philetus/bottery_piccolo/README.md

bottery_piccolo
===============

emerald bottery's fork of diatom's piccolo tiny cnc
