philetus/bottery_piccolo/telaio/telaio_v7_Instructions.pdf

## Telaio v7 Assembly Diagrams

## Z - Stage

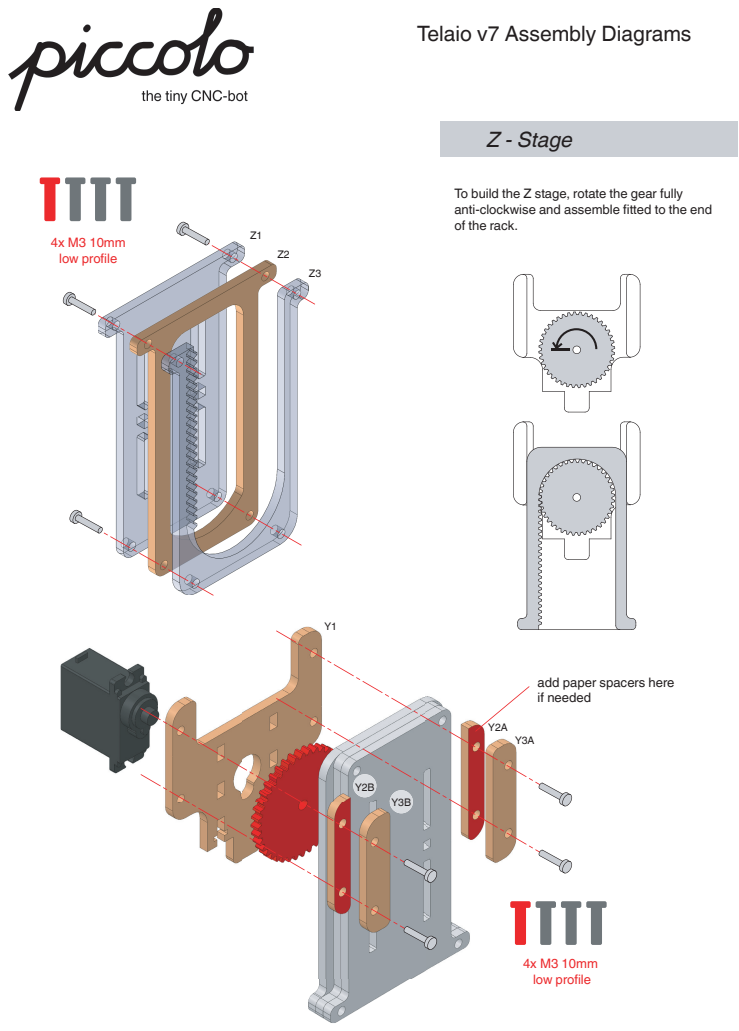
[picture p1: page 1]
4x M3 10mm low profile

To build the Z stage, rotate the gear fully
anti-clockwise and assemble fitted to the end
of the rack.

add paper spacers here
if needed

## X & Y - Stages

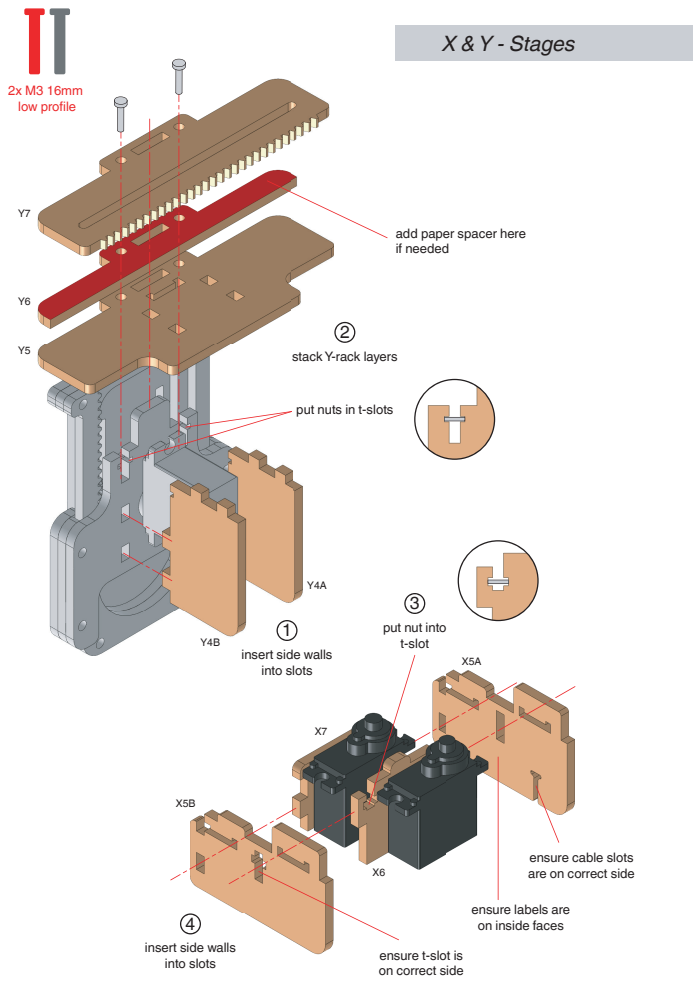
[picture p2: page 2]
2x M3 16mm low profile; put nut into; t-slot

add paper spacer here
if needed

stack Y-rack layers

put nuts in t-slots

insert side walls
into slots

ensure cable slots
are on correct side

ensure labels are
on inside faces

ensure t-slot is
on correct side

3

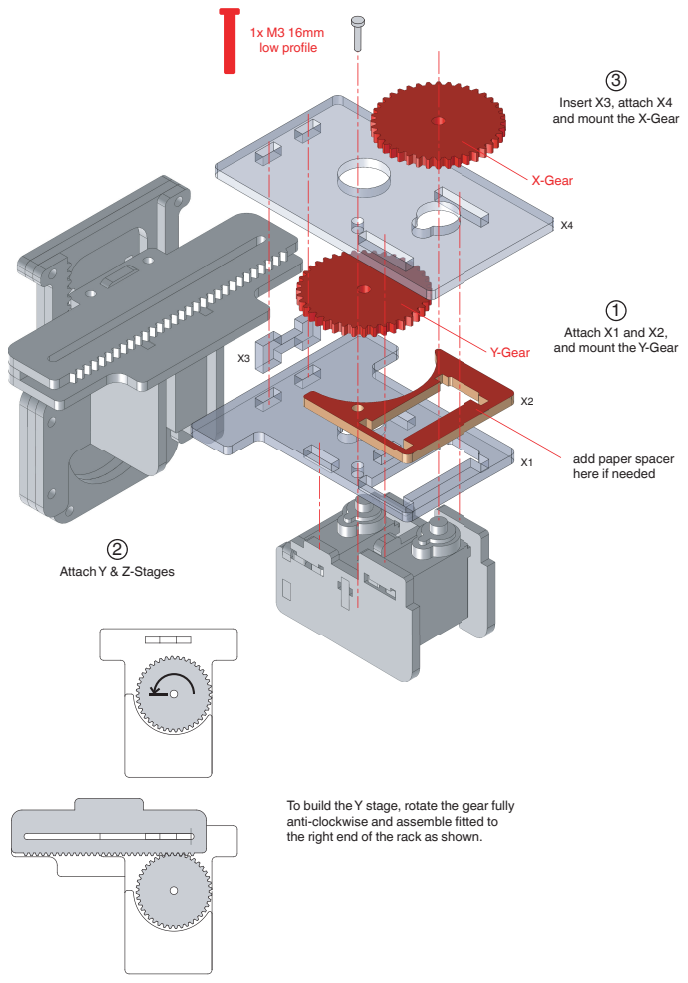
[picture p3: page 3]
1x M3 16mm low profile; Y-Gear; X-Gear; Attach Y & Z-Stages

Insert X3, attach X4
and mount the X-Gear

Attach X1 and X2,
and mount the Y-Gear

add paper spacer
here if needed

To build the Y stage, rotate the gear fully
anti-clockwise and assemble fitted to
the right end of the rack as shown.

## Base and PCB

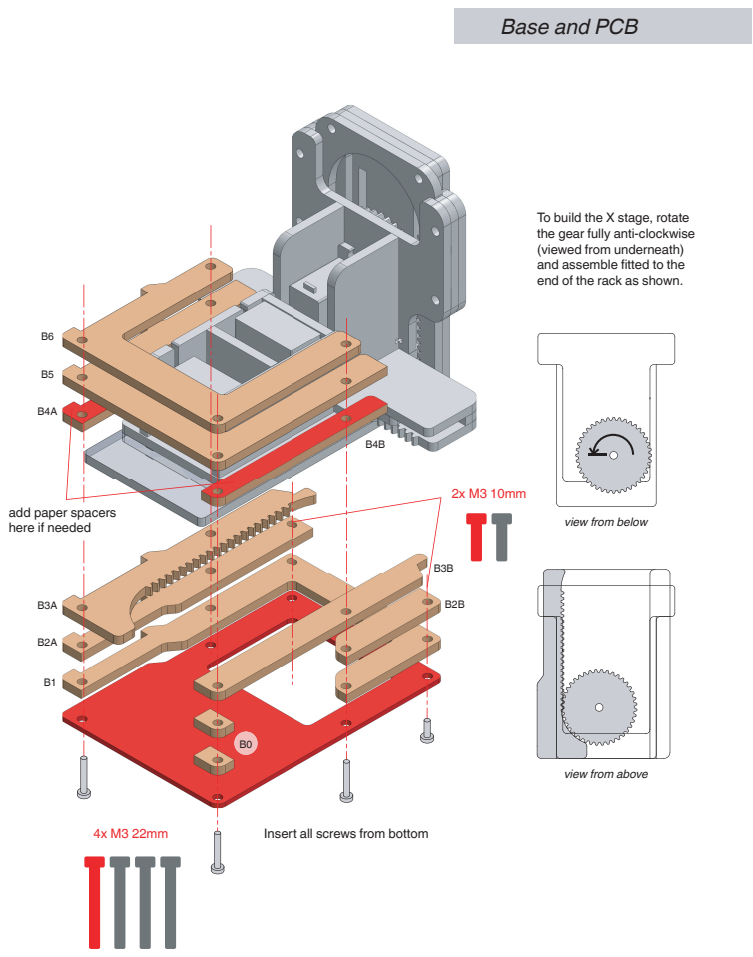
[picture p4: page 4]

To build the X stage, rotate
the gear fully anti-clockwise
(viewed from underneath)
and assemble fitted to the
end of the rack as shown.

add paper spacers
here if needed

view from below

view from above

Insert all screws from bottom

## Finished!

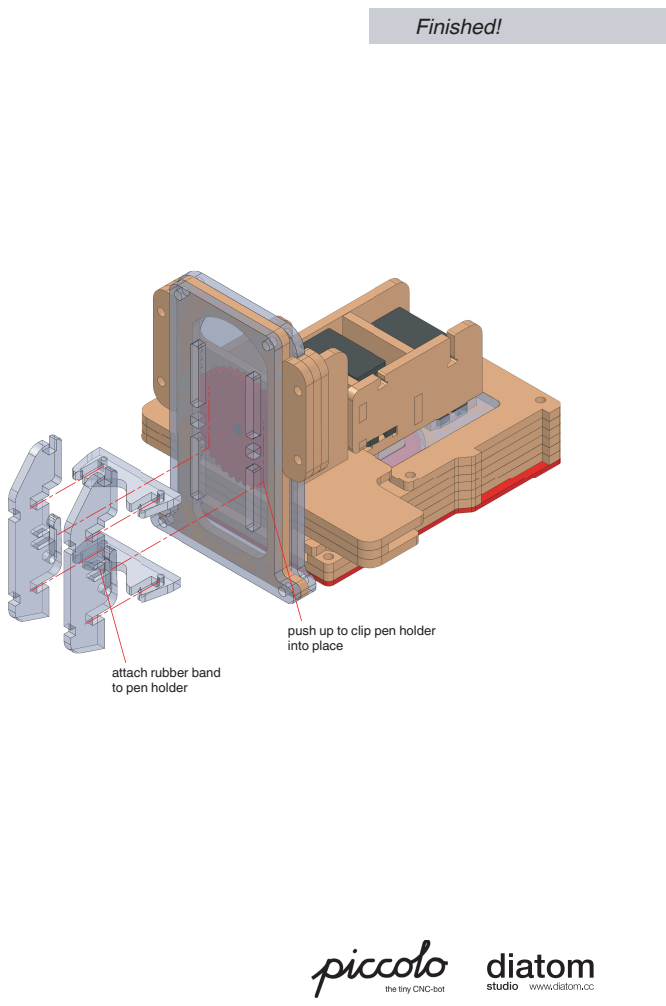
[picture p5: page 5]

push up to clip pen holder
into place

attach rubber band
to pen holder
