philetus/bottery_piccolo/telaio/pcb/Piccolo_pcb_v0.9.1_schematic-rough.pdf

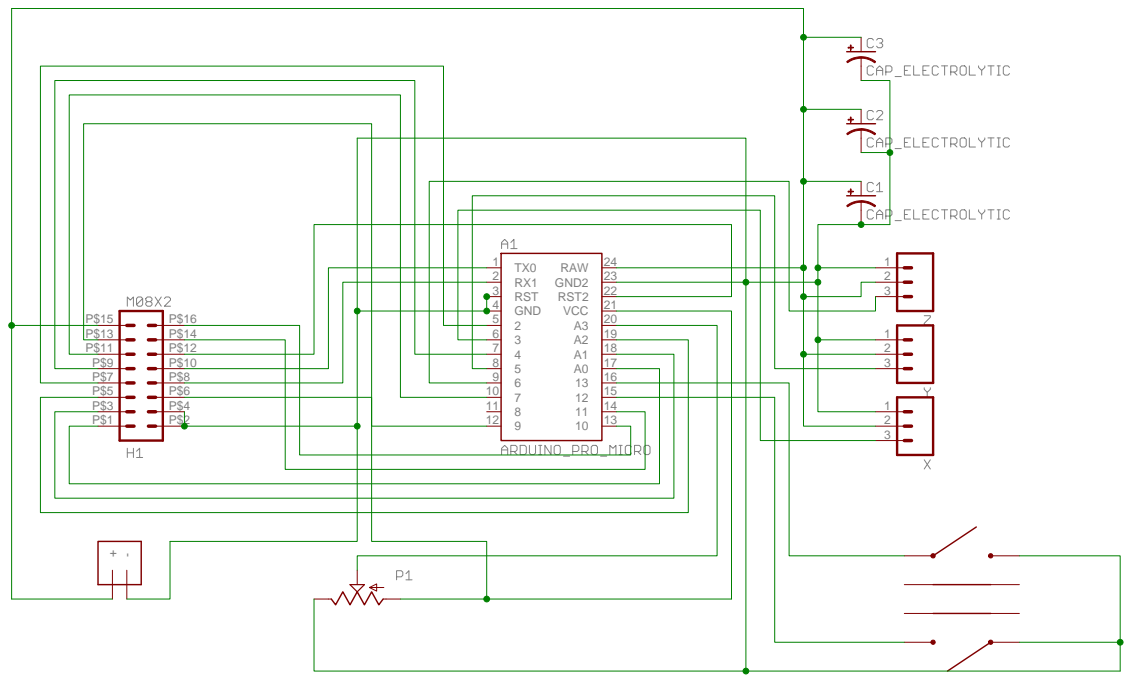
[picture p6: page 1]
20 GND 4; GND2; 23 RAW; RST 3; RST2; VCC
