philetus/bottery_piccolo/(commit log)

2013-12-15 added diatom's piccolo files to git repo
    [Piccolo_pcb_v0.9.1.GBL, Piccolo_pcb_v0.9.1.GBO, Piccolo_pcb_v0.9.1.GBS, Piccolo_pcb_v0.9.1.GTL, Piccolo_pcb_v0.9.1.GTO, Piccolo_pcb_v0.9.1.GTS]
2013-12-17 broke parts out into acrylic inkscape cut file and paper cut file
2013-12-17 finished first layout for lasering 3mm acrylic parts
